ddhhieu/CCVA-HSRL-B6-02/Pictures/Xe_huong_nhin_tu_tren_xuong_cam_bien_huong_len.jpg

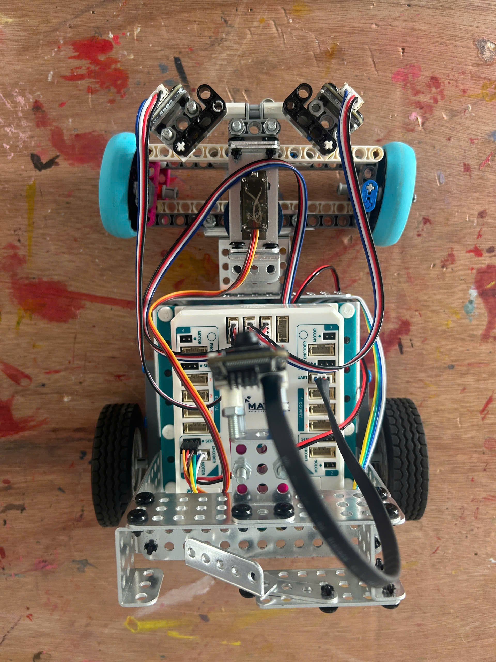
Pictures/Xe_huong_nhin_tu_tren_xuong_cam_bien_huong_len.jpg
