ddhhieu/CCVA-HSRL-B6-02/Pictures/Xe_nhin_tu_mat_duoi.jpg

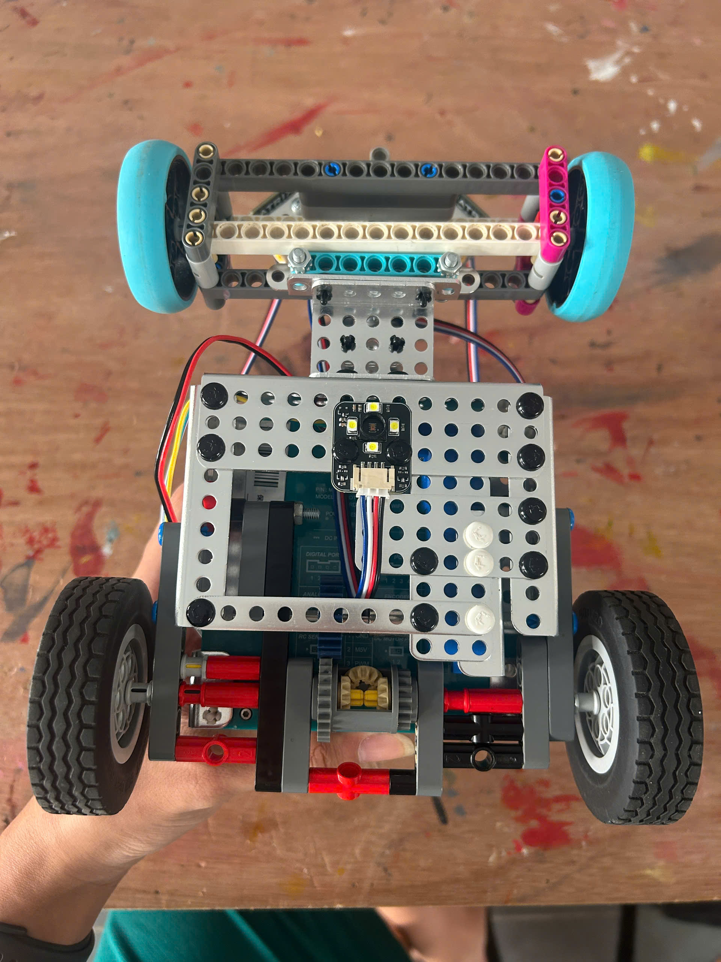
Pictures/Xe_nhin_tu_mat_duoi.jpg
