ddhhieu/CCVA-HSRL-B6-02/(commit log)

2026-07-23 Update Slide lắp ráp.pdf
2026-07-24 fix: Lỗi slide lắp ráp
2026-07-29 Add files via upload
    Báo cáo kĩ thuật
