ddhhieu/CCVA-HSRL-B6-02/(notices)

Notices in the files:
README.md:
License: MIT
